mtu-ieee/BallBot/README.md

BallBot
=======

BallBot central repository for the MTU IEEE chapter.

This project is an attempt to make first a prototype ~14" tall ballbot, based on a mouse drive and a racquetball, followed eventually by a full-size ~4' ballbot based on a kiwi drive and a basketball.
