mtu-ieee/BallBot/micro/Doc/BallBot_micro.png

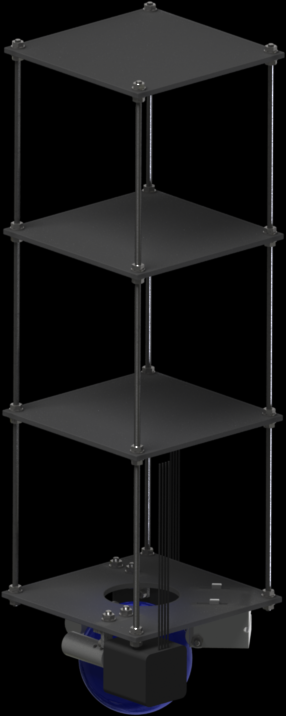
micro/Doc/BallBot_micro.png
