mtu-ieee/BallBot/micro/Doc/BOM.xls

Part Number | QTY | Stock Number | Vendor | Description | Price | Subtotal | $51.55
Racquetball | 1 |  | ??? | ball |  | $0.00
1/2" dia. Nylon/delrin rod x 1' | 1 | 8682K83 | McMaster-Carr | rollers, idler |  | $4.78 |  | Ordered
1/2" 1/16" thick angle aluminum x 4' | 1 | 8982K541 | McMaster-Carr | stepper brackets |  | $2.29 |  | Ordered
Tension_Housing | 1 |  | ??? | printed |  | $0.00
DIN 975 M3 x 0.5 x 1m threaded rod | 3 | 11505177 | Fastenal | rods | $1.29 | $3.87 |  | Ordered
ANSI B 18.2.4.1 M - M3 x 0.5 | 40 | 40142 | Fastenal | Hex Nut | $0.02 | $0.62 |  | Ordered
DIN 916 M3x0.5 x 5 cup set screw | 10 | 40817 | Fastenal | stepper set screws | $0.05 | $0.53 |  | Ordered
ANSI B18.3.1M - M2.5x0.45 x 10 | 10 | 134607 | Fastenal | stepper face holes | $0.14 | $1.43 |  | Ordered
ANSI B18.3.1M - M3x0.5 x 10 | 10 | 39504 | Fastenal | stepper bracket holes | $0.18 | $1.84 |  | Ordered
ANSI B18.22M - 3 N Batch 100 | 1 | 11512291 | Fastenal | Metric Plain Washers | $4.30 | $4.30 |  | Ordered
100mm x 100mm x 3mm acrylic | 4 | -- | Mike | platforms | $0.00 | $0.00
NEMA 11 1.8d stepper | 2 | 1205 | Pololu | drive motors | $15.95 | $31.90 |  | Ordered
