mtu-ieee/BallBot/macro/Doc/BallBot.xls

Quantity | Description | Part Number | Vendor | Price | Subtotal | $3080.07
8 | 3.2V 20AH LiFePO4 | B0021ZB6VE | Amazon | $47.52 | $380.16
3 | 1/8” key | AM-1043 | AndyMark.com | $0.70 | $2.10
3 | 500 Hub | AM-0077 | AndyMark.com | $15.00 | $45.00
3 | 4” Omni Wheel | AM-0383 | AndyMark.com | $19.00 | $57.00
3 | CIM Motor | AM-0255 | AndyMark.com | $28.00 | $84.00
1 | BaneBots RS555 Motor | RS555 | BaneBots | $6.25 | $6.25
2 | 1.5” square bearing block | PB-S5001-BB-0 | BaneBots | $10.00 | $20.00
3 | 2.5” square bearing block | PB-S5002-BB | BaneBots | $12.00 | $36.00
1 | BaneBots 9A ESC | BB-0309 | BaneBots | $28.75 | $28.75
1 | P60 16:1 planetary gearbox | P60K-44-0004 | BaneBots | $54.50 | $54.50
3 | P80 12:1 planetary gearbox | P80K-43-0005 | BaneBots | $124.75 | $374.25
1 | 4” stroke 3/4” bore pneumatic cylinder | BF-0074-DQ | Bimba | $31.90 | $31.90
3 | 18” stroke 3/4” bore pneumatic cylinders | BF-00718-DJRQ | Bimba | $75.90 | $227.70
4 | Capacitive Quadrature Encoder 2048 ppr | 102-1307-ND | Digikey | $23.63 | $94.52
1 | PandaBoard ES | 1055-1000-ND | Digikey | $161.64 | $161.64
1 | Battery charger | DYN4065 | DynamiteRC.com | $44.99 | $44.99
1 | brass joiner |  | FRC 857 | $0.50 | $0.50
2 | brass tee |  | FRC 857 | $0.50 | $1.00
4 | plastic tee |  | FRC 857 | $0.50 | $2.00
16 | Quick-release connectors |  | FRC 857 | $0.50 | $8.00
10 | Foot 1/4” pneumatic tubing |  | FRC 857 | $1.00 | $10.00
1 | Mechanical release valve |  | FRC 857 | $2.00 | $2.00
1 | pressure switch |  | FRC 857 | $2.00 | $2.00
1 | safety relief valve |  | FRC 857 | $2.00 | $2.00
1 | gauge |  | FRC 857 | $3.00 | $3.00
1 | Single-port solenoid valve |  | FRC 857 | $8.00 | $8.00
1 | Dual-port solenoid valves |  | FRC 857 | $10.00 | $10.00
1 | regular accumulator |  | FRC 857 | $10.00 | $10.00
1 | spike relay |  | FRC 857 | $10.00 | $10.00
1 | compressor |  | FRC 857 | $20.00 | $20.00
16 | 1” Concealed 90d connectors | 47065T155 | McMaster-Carr | $1.79 | $28.64
8 | 1” cube three-way corners | 47065T101 | McMaster-Carr | $9.86 | $78.88
1 | 1/2”-10 3' Acme rod | 99030A005 | McMaster-Carr | $15.60 | $15.60
1 | 1/2”-10 Acme nut | 95075A106 | McMaster-Carr | $22.55 | $22.55
3 | 1” square 10' t-slot aluminum | 47065T101 | McMaster-Carr | $31.59 | $94.77
1 | 1/2”-10 Acme nut mounting flange | 95082A642 | McMaster-Carr | $44.78 | $44.78
32 | Devantech SRF02 ultrasonic ranger | RB-Dev-20 | RobotShop.com | $19.41 | $621.12
8 | IR cliff sensor | SEN-08959 | Sparkfun.com | $13.95 | $111.60
1 | 3-axis magnetometer | SEN-10619 | Sparkfun.com | $14.95 | $14.95
1 | 6-axis IMU | SEN-11028 | Sparkfun.com | $39.95 | $39.95
3 | Victor 884 12V, 12V fan | VICTOR | VexRobotics.com | $89.99 | $269.97
