mtu-ieee/BallBot/micro/CAD/STL/Roller.stl

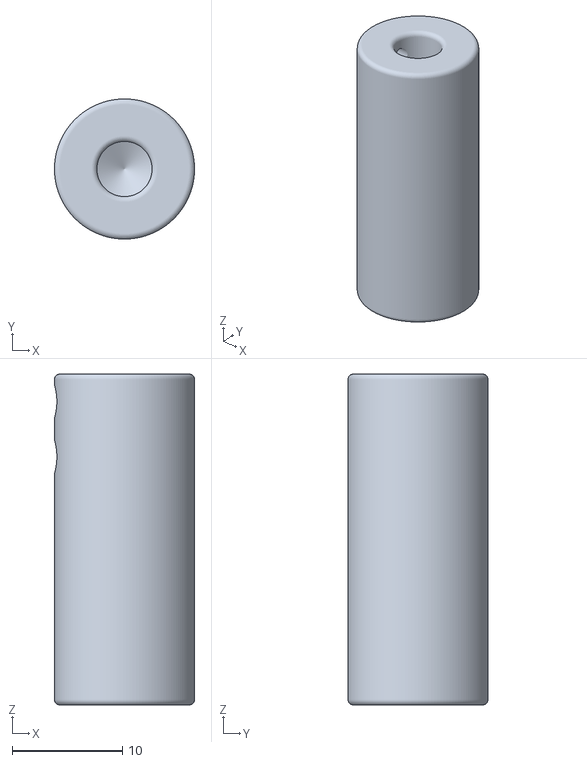
[picture p2: CAD file, 2012-10-07]
micro/CAD/STL/Roller.stl
12.7 x 12.7 x 30.0
