mtu-ieee/BallBot/micro/CAD/STL/Tension_Housing.stl

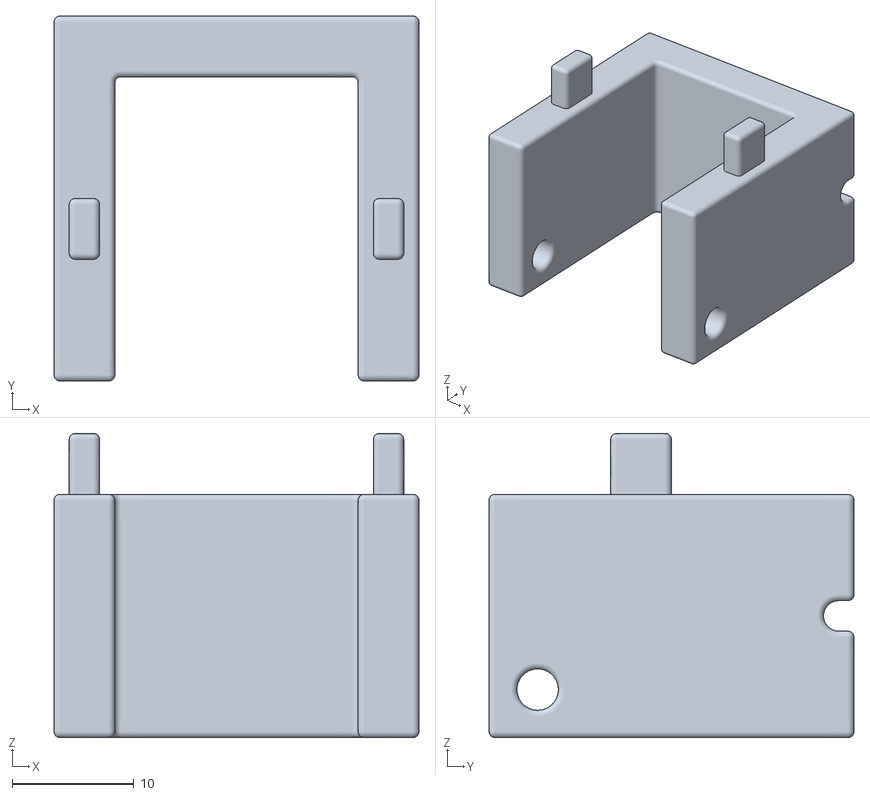
[picture p3: CAD file, 2012-10-07]
micro/CAD/STL/Tension_Housing.stl
30.0 x 30.0 x 25.0
