mtu-ieee/BallBot/micro/CAD/STL/Idler.stl

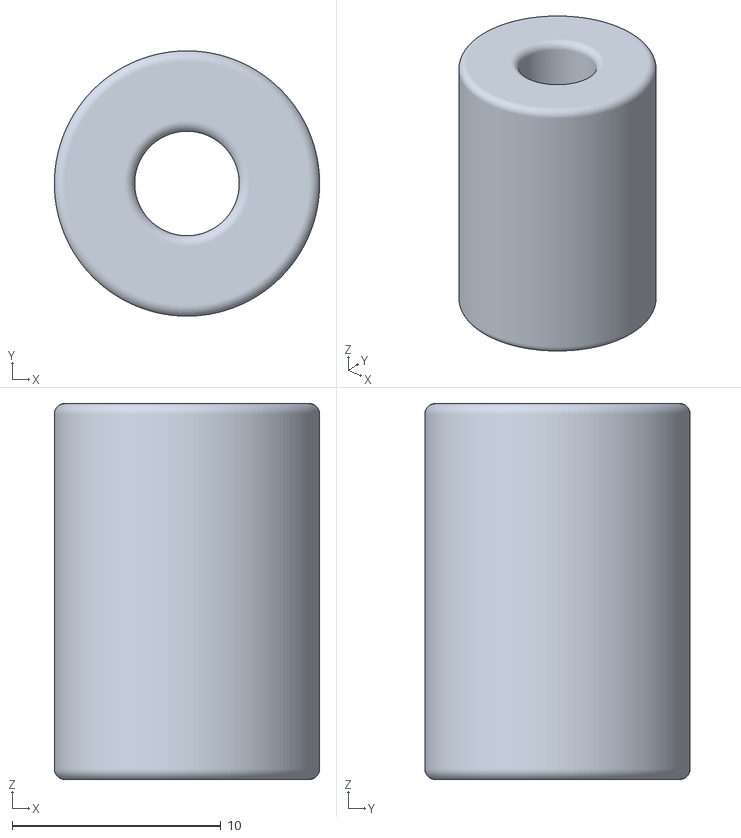
[picture p4: CAD file, 2012-10-07]
micro/CAD/STL/Idler.stl
12.7 x 12.7 x 18.0
