mtu-ieee/BallBot/micro/CAD/STL/Stepper_Bracket.stl

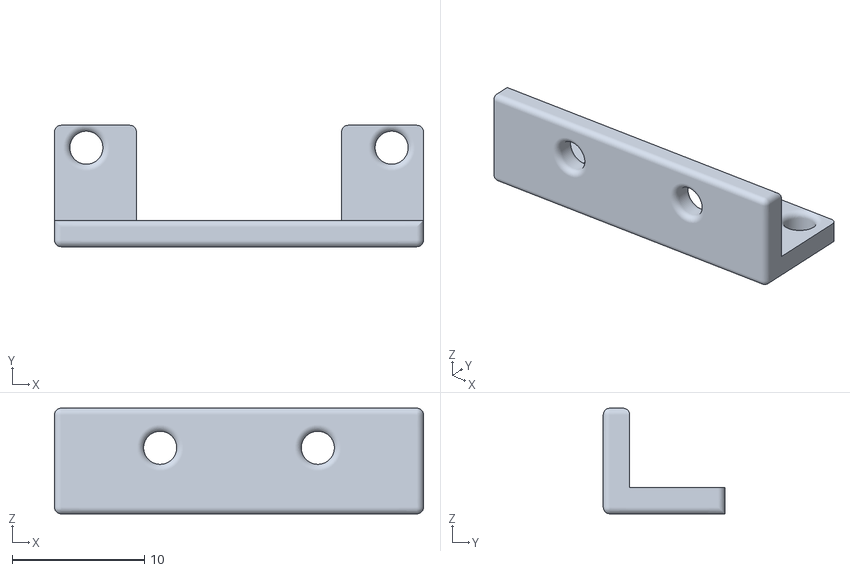
[picture p5: CAD file, 2012-10-07]
micro/CAD/STL/Stepper_Bracket.stl
27.9 x 9.20 x 8.00
