mtu-ieee/BallBot/(list of files, cad)

Other CAD files:
macro/CAD/1010_80_20.ipt
macro/CAD/500-key-hub/500-key-hub.ipt
macro/CAD/BB15_block.iam
macro/CAD/BB15_block.ipt
macro/CAD/BB25_block.iam
macro/CAD/BB25_block.ipt
macro/CAD/BallBot_macro.iam
macro/CAD/BasketBall.ipt
macro/CAD/Drivetrain_Module.iam
macro/CAD/Omni_Wheel/10-32x0500_shcs.ipt
macro/CAD/Omni_Wheel/125x1000dowel.ipt
macro/CAD/Omni_Wheel/4-inch-omni-wheel.iam
macro/CAD/Omni_Wheel/4_inch_omni_wheel.ipt
macro/CAD/Omni_Wheel/8_roller1.iam
macro/CAD/Omni_Wheel/8x750roller.ipt
macro/CAD/Omni_Wheel/M5_Nylock-nut.ipt
macro/CAD/Omni_Wheel/a42b_eyelet.ipt
macro/CAD/P60/BB-42016.iam
macro/CAD/P60/BB5-Axle.ipt
macro/CAD/P60/BB5-BackPlate.ipt
macro/CAD/P60/BB5-Bearing.ipt
macro/CAD/P60/BB5-FrontPlate.ipt
macro/CAD/P60/BB5-RingGear.ipt
macro/CAD/P60/FisherPriceMotor.ipt
macro/CAD/P80/10-24 UNC x 4_ Phillips Pan Head.ipt
macro/CAD/P80/BB-56012.iam
macro/CAD/P80/BB2-BackPlate.ipt
macro/CAD/P80/BB2-FrontPlate.ipt
macro/CAD/P80/BB2-InterfacePlate.ipt
macro/CAD/P80/BB2-OutputShaft.ipt
macro/CAD/P80/BB2-RingGear.ipt
macro/CAD/P80/CIM Motor.iam
macro/CAD/P80/CIM motor.ipt
macro/CAD/P80/Phillips Pan Head Machine Screw Inch.ipt
macro/CAD/P80/br-8.ipt
macro/CAD/Pnuematics/Double Solenoid Valve.ipt
macro/CAD/Pnuematics/Festo Port Fitting.ipt
macro/CAD/Pnuematics/Festo Solenoid Nut.ipt
macro/CAD/Pnuematics/Festo Solenoid.ipt
macro/CAD/Pnuematics/Festo Valve Assembly.iam
macro/CAD/Pnuematics/Festo Valve.ipt
macro/CAD/Pnuematics/brasstee.ipt
macro/CAD/Pnuematics/compressor.iam
macro/CAD/Pnuematics/compressorbody.ipt
macro/CAD/Pnuematics/compressorhead.ipt
macro/CAD/Pnuematics/compressormotorbody.ipt
macro/CAD/Pnuematics/compressormotorcap.ipt
macro/CAD/Pnuematics/compressorplate.ipt
macro/CAD/Pnuematics/compressorvalve.ipt
macro/CAD/Pnuematics/cylinder0750-1.ipt
macro/CAD/Pnuematics/cylinder0750-2.ipt
macro/CAD/Pnuematics/cylinder0750-3.ipt
macro/CAD/Pnuematics/cylinder0750-4.ipt
macro/CAD/Pnuematics/cylinder0750-5.ipt
macro/CAD/Pnuematics/cylinder0750x1.iam
macro/CAD/Pnuematics/hexnipple.ipt
macro/CAD/Pnuematics/i-CylinderBody.ipt
macro/CAD/Pnuematics/pressuregage.iam
macro/CAD/Pnuematics/pressuregage1.ipt
macro/CAD/Pnuematics/pressuregage2.ipt
macro/CAD/Pnuematics/pressuregage3.ipt
macro/CAD/Pnuematics/pressuregage4.ipt
macro/CAD/Pnuematics/pressureswitch2.ipt
macro/CAD/Pnuematics/smcstraight.iam
macro/CAD/Pnuematics/smcstraight1.ipt
macro/CAD/Pnuematics/smcstraight2.ipt
macro/CAD/Pnuematics/smcteeunion.iam
macro/CAD/Pnuematics/smcteeunion1.ipt
macro/CAD/Pnuematics/smcteeunion2.ipt
macro/CAD/Pnuematics/smcteeunion3.ipt
macro/CAD/Pnuematics/smcteeunion4.ipt
macro/CAD/Pnuematics/volumetank.iam
macro/CAD/Pnuematics/volumetank1.ipt
macro/CAD/Pnuematics/volumetank2.ipt
macro/CAD/Pnuematics/volumetank3.ipt
macro/CAD/Victor/Fan-PAPST-412.ipt
macro/CAD/Victor/Victor884 Screw Terminal.ipt
macro/CAD/Victor/Victor884-3 Pin Connector.ipt
macro/CAD/Victor/Victor884-Base.ipt
macro/CAD/Victor/Victor884-Capacitor.ipt
macro/CAD/Victor/Victor884-Cover.ipt
macro/CAD/Victor/Victor884-Fet.ipt
macro/CAD/Victor/Victor884-LED - Green.ipt
macro/CAD/Victor/Victor884-PCB.ipt
macro/CAD/Victor/Victor884.iam
macro/CAD/drive_frame_bracket.ipt
macro/CAD/drive_frame_endpiece.iam
macro/CAD/drive_frame_endpiece.ipt
macro/CAD/drive_frame_endpiece/Frame/ANSI 00000001.ipt
macro/CAD/drive_frame_endpiece/Frame/Skeleton0001.ipt
macro/CAD/drive_frame_endpiece/Frame/drive_frame_endpiece0001.iam
macro/CAD/drive_frame_rail.iam
macro/CAD/drive_frame_rail.ipt
macro/CAD/drive_frame_rail/Frame/ANSI 00000001.ipt
macro/CAD/drive_frame_rail/Frame/Skeleton0001.ipt
macro/CAD/drive_frame_rail/Frame/drive_frame_rail001.iam
macro/CAD/drive_frame_spacer.iam
macro/CAD/drive_frame_spacer.ipt
macro/CAD/drive_frame_spacer/Frame/ANSI 00000001.ipt
macro/CAD/drive_frame_spacer/Frame/Skeleton0001.ipt
macro/CAD/drive_frame_spacer/Frame/drive_frame_spacer001.iam
macro/CAD/frame.iam
macro/CAD/frame.ipt
macro/CAD/frame/Frame/ANSI 00000001.ipt
macro/CAD/frame/Frame/ANSI 00000002.ipt
macro/CAD/frame/Frame/ANSI 00000003.ipt
macro/CAD/frame/Frame/ANSI 00000004.ipt
macro/CAD/frame/Frame/ANSI 00000005.ipt
macro/CAD/frame/Frame/ANSI 00000006.ipt
macro/CAD/frame/Frame/ANSI 00000007.ipt
macro/CAD/frame/Frame/ANSI 00000008.ipt
macro/CAD/frame/Frame/ANSI 00000009.ipt
macro/CAD/frame/Frame/ANSI 00000010.ipt
macro/CAD/frame/Frame/ANSI 00000011.ipt
macro/CAD/frame/Frame/ANSI 00000012.ipt
macro/CAD/frame/Frame/Frame0001.iam
macro/CAD/frame/Frame/Skeleton0001.ipt
macro/CAD/wheel_key.ipt
micro/CAD/211-13-01.ipt
micro/CAD/Ball.ipt
micro/CAD/BallBot.iam
micro/CAD/Bottom_Platform.ipt
micro/CAD/Idler.ipt
micro/CAD/Platform.ipt
micro/CAD/Rod.ipt
micro/CAD/Roller.ipt
micro/CAD/Stepper_Bracket.ipt
micro/CAD/Tension_Housing.ipt
micro/Prints/IDW/BallBot_micro.idw
micro/Prints/IDW/Bottom_Platform.idw
micro/Prints/IDW/Idler.idw
micro/Prints/IDW/Platform.idw
micro/Prints/IDW/Roller.idw
micro/Prints/IDW/Stepper_Bracket.idw
micro/Prints/IDW/Tension_Housing.idw
