mtu-ieee/BallBot/micro/Prints/PDF/BBU-001_Stepper_Bracket.pdf

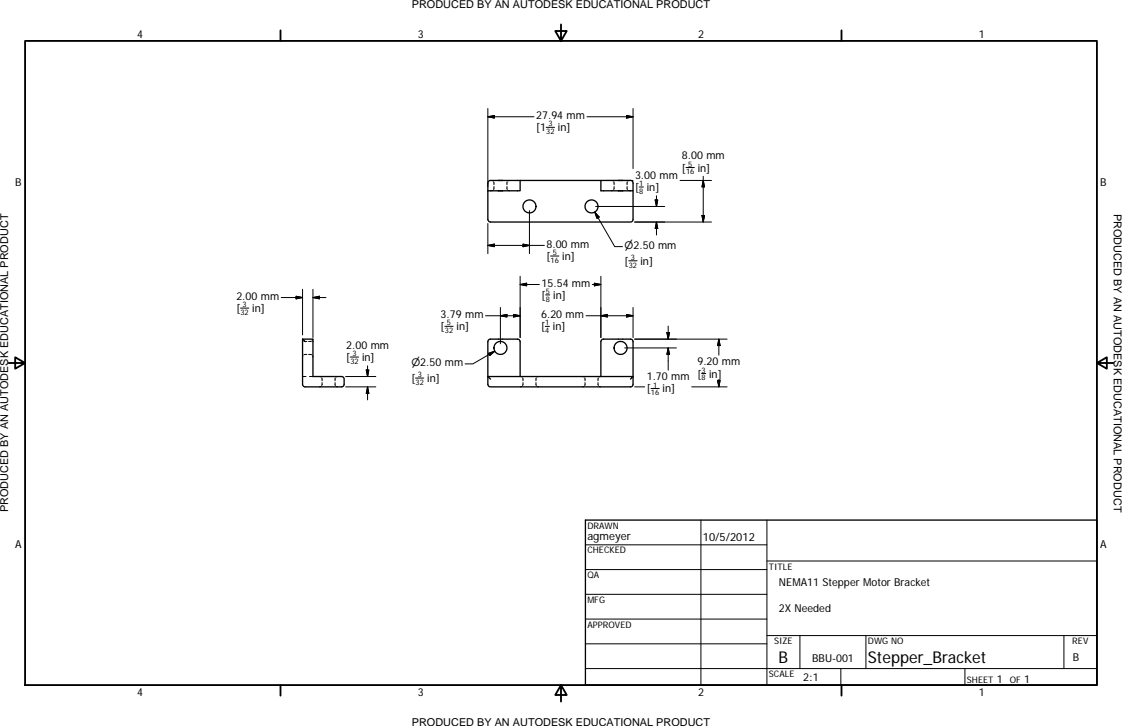
[picture p6: page 1]
2X Needed

PRODUCED BY AN AUTODESK EDUCATIONAL PRODUCT

DRAWN agmeyer | 10/5/2012

CHECKED

TITLE
NEMA11 Stepper Motor Bracket

MFG

APPROVED

SIZE B | BBU-001 | DWG NO Stepper_Bracket | REV B

SCALE 2:1 | | SHEET 1 OF 1
