mtu-ieee/BallBot/micro/Prints/PDF/BBU-003_Tension_Housing.pdf

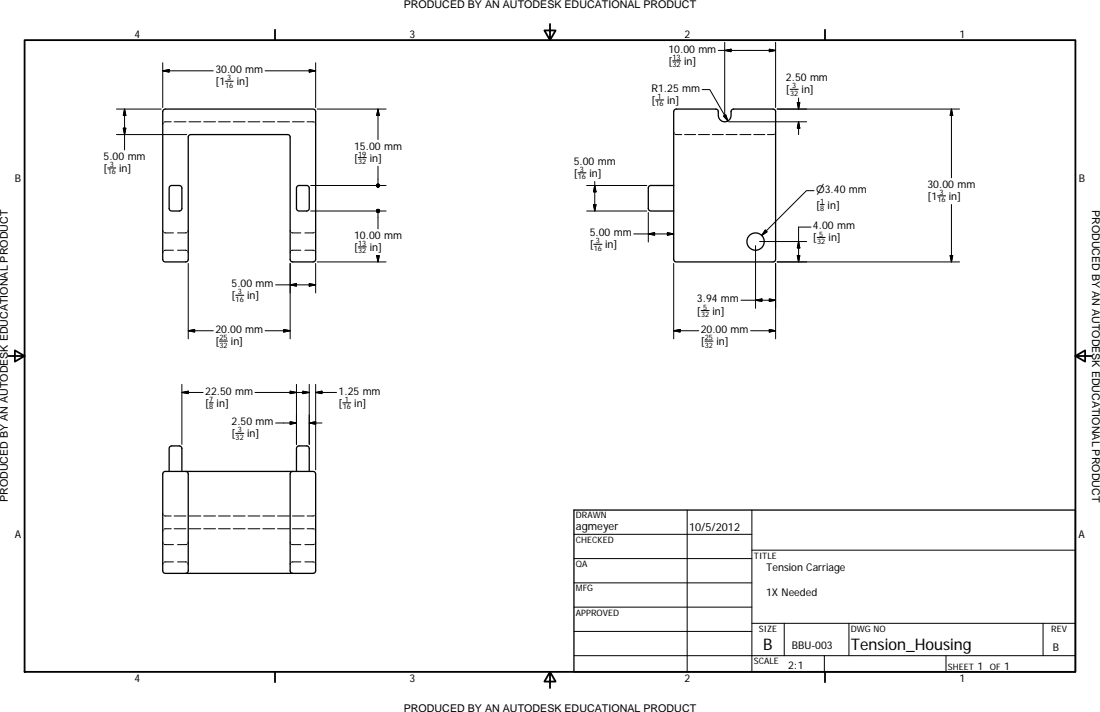
[picture p7: page 1]
TITLE Tension Carriage; 1X Needed

PRODUCED BY AN AUTODESK EDUCATIONAL PRODUCT

DRAWN agmeyer | 10/5/2012

CHECKED

MFG

APPROVED

SIZE B | BBU-003 | DWG NO Tension_Housing | REV B

SCALE 2:1 | | SHEET 1 OF 1
