mtu-ieee/BallBot/micro/Prints/PDF/BBU-006_Idler.pdf

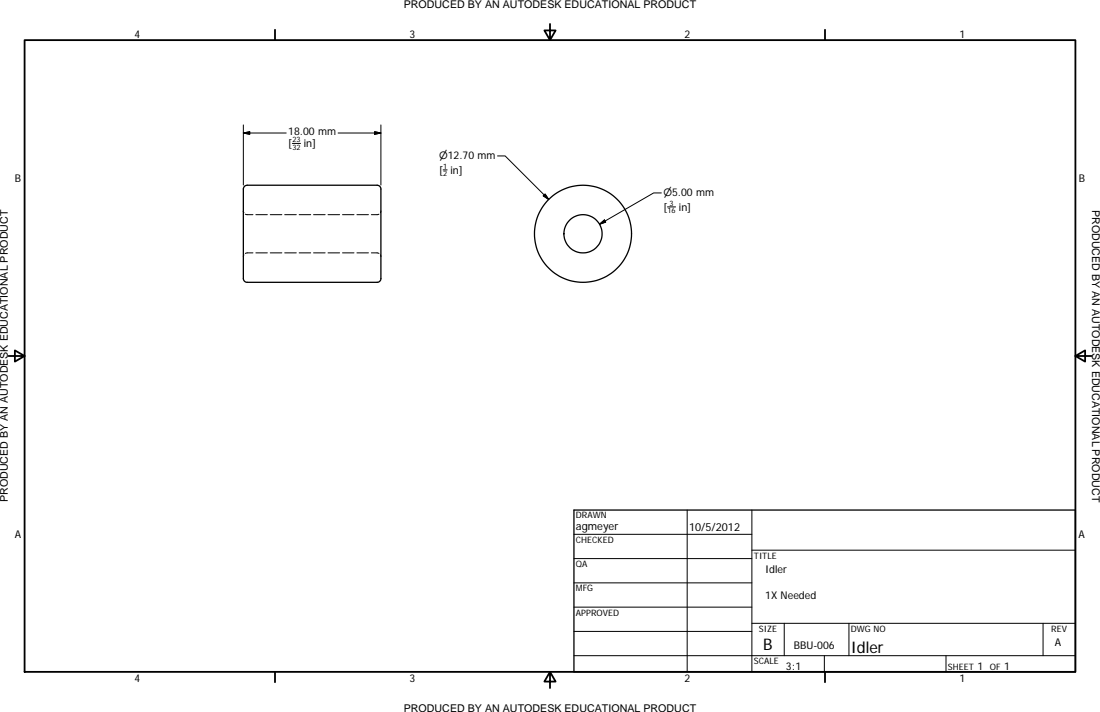
[picture p8: page 1]
CED BY; ODE; ATI; PRODUCED BY; AUTODESK EDUC; ATION; AL PRODUCT; TITLE Idler; 1X Needed

PRODUCED BY AN AUTODESK EDUCAT OI NAL PRODUCT

DRAWN agmeyer | 10/5/2012

CHECKED

MFG

APPROVED

SIZE B | BBU-006 | DWG NO Idler | REV A

SCALE 3:1 | | SHEET 1 OF 1
