mtu-ieee/BallBot/micro/Prints/PDF/BBU-000_BallBot_micro.pdf

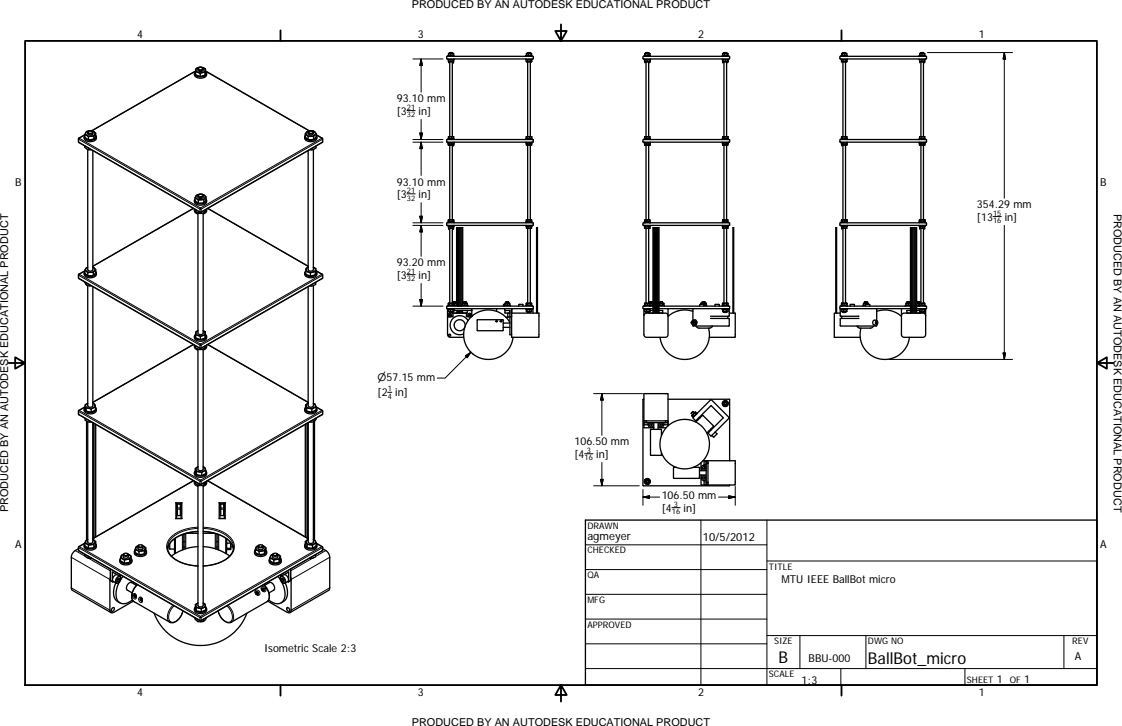
[picture p9: page 1]
Isometric Scale 2:3

PRODUCED BY AN AUTODESK EDUCATIONAL PRODUCT

DRAWN agmeyer | 10/5/2012

CHECKED

TITLE
MTU IEEE BallBot micro

MFG

APPROVED

SIZE B | BBU-000 | DWG NO BallBot_micro | REV A

SCALE 1:3 | | SHEET 1 OF 1
