mtu-ieee/BallBot/micro/Prints/PDF/BBU-002_Bottom_Platform.pdf

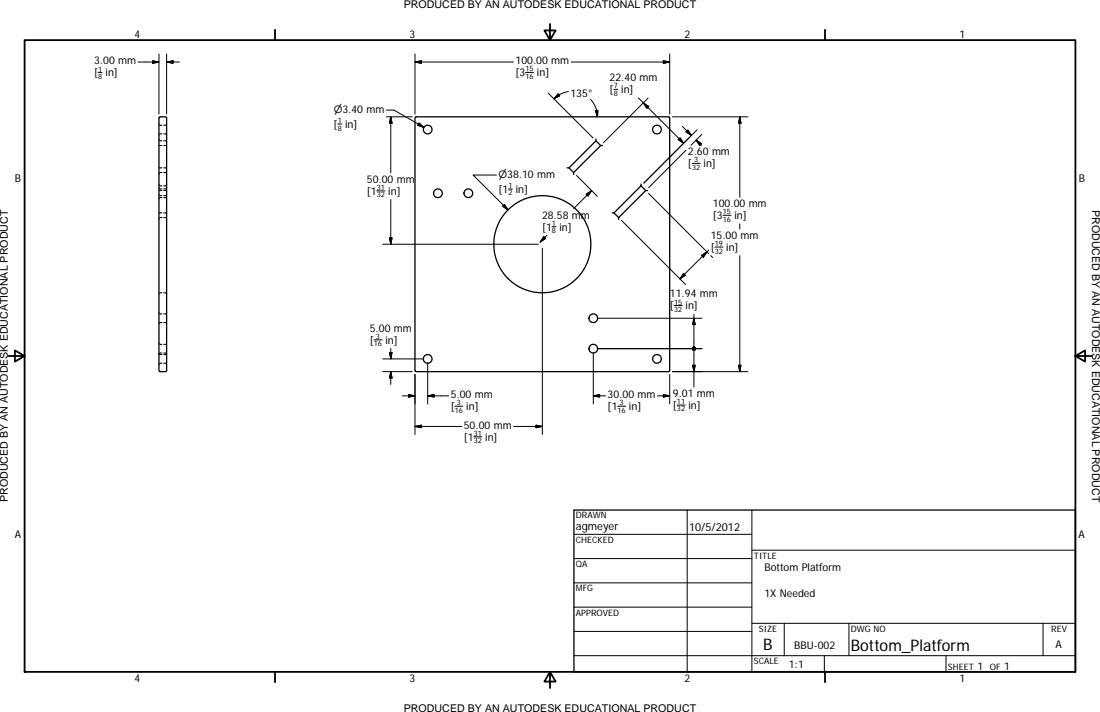
[picture p10: page 1]
CED BY; ODE; ATI; PRODUCED BY; AUTODESK EDUC; ATION; AL PRODUCT; TITLE; Bottom Platform; 1X Needed

PRODUCED BY AN AUTODESK EDUCAT OI NAL PRODUCT

DRAWN agmeyer | 10/5/2012

CHECKED

MFG

APPROVED

SIZE B | BBU-002 | DWG NO Bottom_Platform | REV A

SCALE 1:1 | | SHEET 1 OF 1
