mtu-ieee/BallBot/micro/Prints/PDF/BBU-004_Roller.pdf

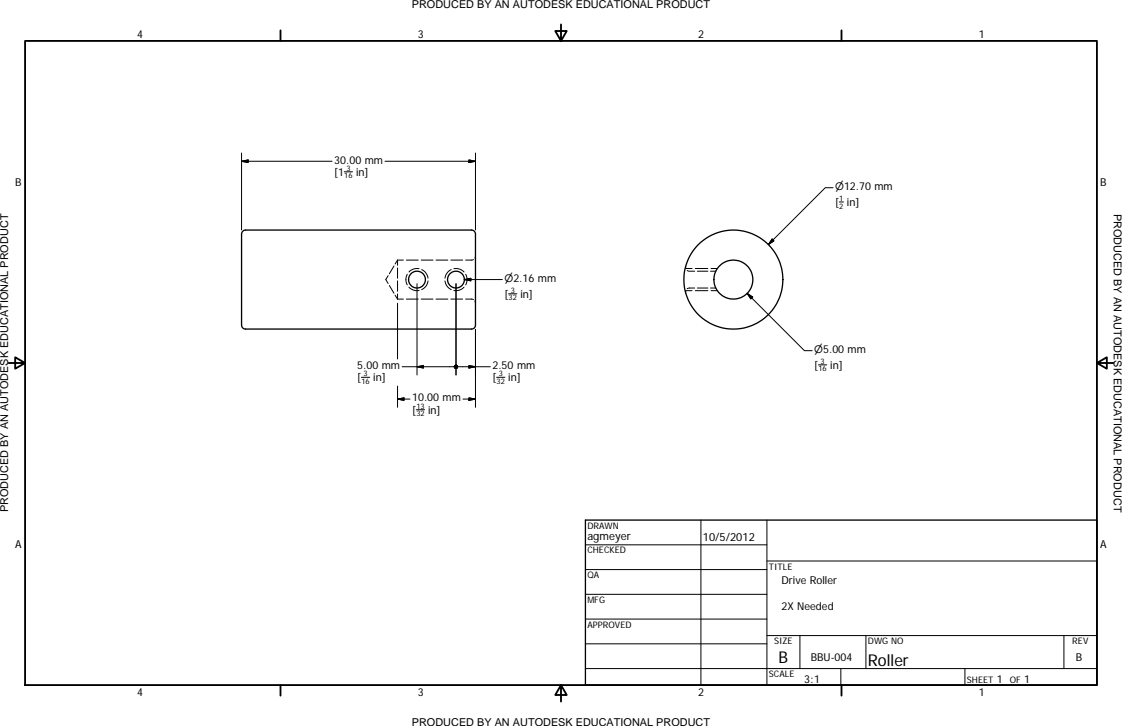
[picture p11: page 1]
TITLE Drive Roller; 2X Needed

PRODUCED BY AN AUTODESK EDUCATIONAL PRODUCT

DRAWN agmeyer | 10/5/2012

CHECKED

MFG

APPROVED

SIZE B | BBU-004 | DWG NO Roller | REV B

SCALE 3:1 | | SHEET 1 OF 1
