mtu-ieee/BallBot/micro/Prints/PDF/BBU-005_Platform.pdf

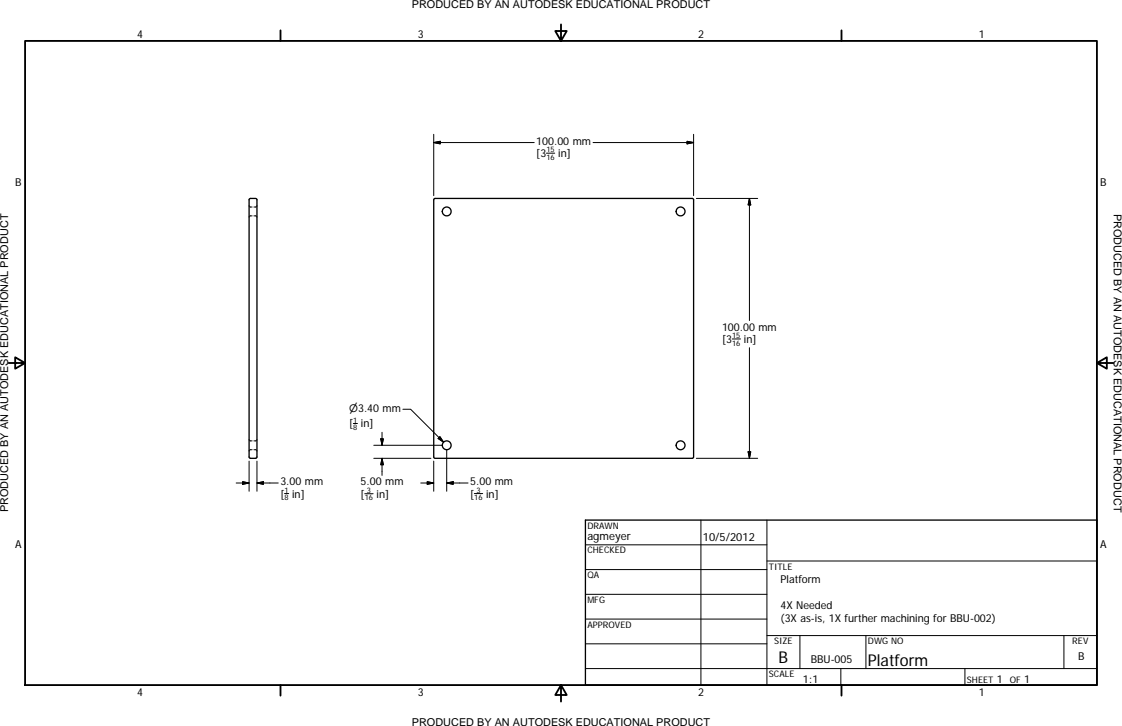
[picture p12: page 1]
TITLE Platform

PRODUCED BY AN AUTODESK EDUCATIONAL PRODUCT

DRAWN agmeyer | 10/5/2012

CHECKED

MFG

4X Needed
(3X as-is, 1X further machining for BBU-002)

APPROVED

SIZE B | BBU-005 | DWG NO Platform | REV B

SCALE 1:1 | | SHEET 1 OF 1
