mtu-ieee/BallBot/micro/ECAD/controls.sch

## EAGLE design micro/ECAD/controls.sch (2012-11-16)

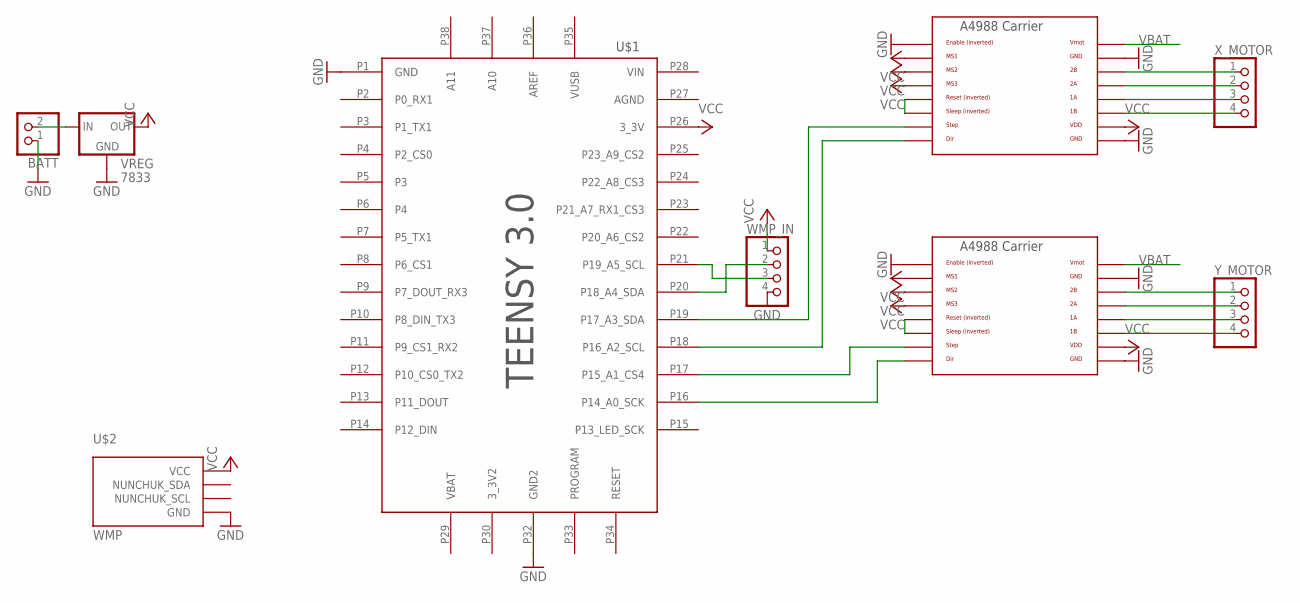
[picture p13: schematic controls.sch]

Parts:
BATT: PINHD-1X2; 1X02
U$1: TEENSY3; TEENSY3_BRD
U$2: WMP
VREG: 7833; 78LXX
WMP_IN: PINHD-1X4/90; 1X04/90
X_DRIVE: POLOLU_A4983CARRIER; A4988BREAKOUT
X_MOTOR: PINHD-1X4/90; 1X04/90
Y_DRIVE: POLOLU_A4983CARRIER; A4988BREAKOUT
Y_MOTOR: PINHD-1X4/90; 1X04/90

Connections:
GND: BATT.1, U$1.P1 (GND), U$1.P32 (GND2), U$2.GND, VREG.GND, WMP_IN.4, X_DRIVE.EN, X_DRIVE.GND, X_DRIVE.GND@0 (GND), Y_DRIVE.EN, Y_DRIVE.GND, Y_DRIVE.GND@0 (GND)
unnamed: X_DRIVE.2B, X_MOTOR.1
unnamed: X_DRIVE.2A, X_MOTOR.2
unnamed: X_DRIVE.1A, X_MOTOR.3
unnamed: X_DRIVE.1B, X_MOTOR.4
unnamed: Y_DRIVE.2B, Y_MOTOR.1
unnamed: Y_DRIVE.2A, Y_MOTOR.2
unnamed: Y_DRIVE.1A, Y_MOTOR.3
unnamed: Y_DRIVE.1B, Y_MOTOR.4
unnamed: Y_DRIVE.RST, Y_DRIVE.SLP (SLEEP)
unnamed: X_DRIVE.RST, X_DRIVE.SLP (SLEEP)
unnamed: U$1.P19 (P17_A3_SDA), X_DRIVE.STEP
unnamed: U$1.P18 (P16_A2_SCL), X_DRIVE.DIR
unnamed: U$1.P17 (P15_A1_CS4), Y_DRIVE.STEP
unnamed: U$1.P16 (P14_A0_SCK), Y_DRIVE.DIR
unnamed: U$1.P20 (P18_A4_SDA), WMP_IN.2
unnamed: U$1.P21 (P19_A5_SCL), WMP_IN.3
VBAT: BATT.2, VREG.IN, X_DRIVE.VMOT, Y_DRIVE.VMOT
VCC: U$1.P26 (3_3V), U$2.VCC, VREG.OUT, WMP_IN.1, X_DRIVE.MS1, X_DRIVE.MS2, X_DRIVE.MS3, X_DRIVE.VDD, Y_DRIVE.MS1, Y_DRIVE.MS2, Y_DRIVE.MS3, Y_DRIVE.VDD
