mtu-ieee/BallBot/(commit log)

2012-10-04 Initial commit, setting up directory structure and macro BOM.
    [BallBot.xls]
2012-10-04 Adding CAD files for micro.
    [211-13-01.ipt, Ball.ipt, BallBot.iam, Bottom_Platform.ipt, Platform.ipt, Rod.ipt, Roller.ipt, Tension_Housing.ipt]
2012-10-05 Finished initial draft for review of mechanical design, generated prints in IDW and PDF copies.
    [BallBot.iam, BallBot_micro.idw, Bottom_Platform.idw, Bottom_Platform.ipt, Idler.idw, Idler.ipt, Platform.idw, Roller.idw]
2012-10-05 Added micro BOM as csv.
    [BOM.csv, BallBot.iam]
2012-10-05 Newer BOM as Excel.
    [BOM.csv, BOM.xls]
2012-10-07 Added STL and BFB files for rapid-prototyping micro components. BFB files are GCODE for a Rapman 3.2, sliced with Kisslicer. Also added BOM for micro.
    [BOM.xls, Idler.stl, Roller.stl, Stepper_Bracket.stl, Tension_Housing.stl, WMP-Nunchuk_Data.ods]
2012-10-07 Added sample data from Wii Motion Plus and Wii Nunchuk used in micro as a 6-DOF IMU.
    [WMP-Nunchuk_Data.xls]
2012-10-07 Added Arduino code to read Wii MotionPlus and Wii Nunchuk over I2C, used to collect data for micro.
    [WMP-Nunchuk_Data.ods]
2012-10-25 Added physical material to the iProperties for micro, added directory structure to macro.
    [1010_80_20.ipt, Ball.ipt, BallBot.xls, Bottom_Platform.ipt, Idler.ipt, Platform.ipt, Rod.ipt, Roller.ipt]
2012-10-25 Added many files for macro's CAD. Frame built, drivetrain module started.
    [10-24 UNC x 4_ Phillips Pan Head.ipt, 10-32x0500_shcs.ipt, 1010_80_20.ipt, 125x1000dowel.ipt, 4-inch-omni-wheel.iam, 4_inch_omni_wheel.ipt, 500-key-hub.ipt, 8_roller1.iam]
2012-10-26 Added framing to macro drivetrain module, updated material properties of micro.
    [ANSI 00000001.ipt, Ball.ipt, BallBot_macro.iam, BasketBall.ipt, Drivetrain_Module.iam, Skeleton0001.ipt, drive_frame_rail.iam, drive_frame_rail.ipt]
2012-10-26 Created a quick frame for the drivetrain modules to attach to. Still figuring out how to get all three wheels onto the basketball...
    [10-24 UNC x 4_ Phillips Pan Head.ipt, 1010_80_20.ipt, 4-inch-omni-wheel.iam, 8_roller1.iam, ANSI 00000001.ipt, BB-56012.iam, BallBot_macro.iam, CIM Motor.iam]
2012-11-16 Beginnings of control PCB. Pololu stepper drivers connected, WMP port connected. Need to finalise Nunchuk footprint, and connect in schematic. Need to route board.
    [controls.sch]
